arribada/argos-smd-hw/module-BGA_RG-4layers_v1.0.step

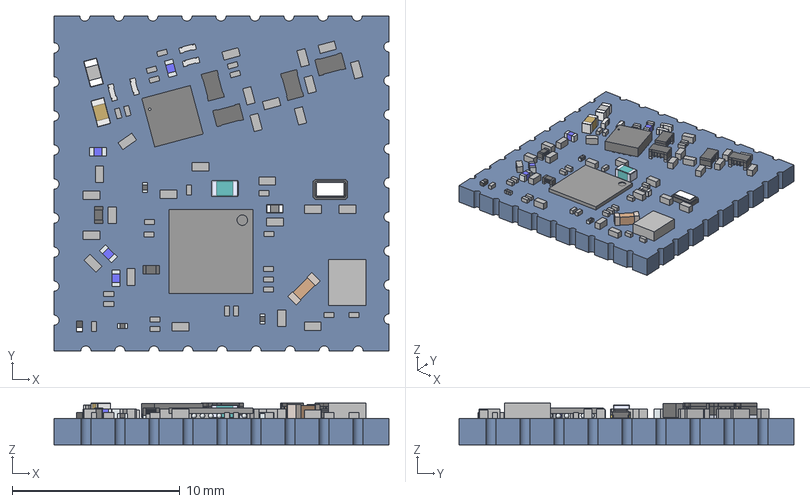
[picture p3: CAD file, 2025-10-09]
module-BGA_RG-4layers_v1.0.step
20.0 x 20.0 x 2.49 mm
Extruded x 55
term1 x 7
term2 x 7
Rect1 x 2
Rect2 x 2
Rect3 x 2
Rect4 x 2
Rect5 x 2
Rect6 x 2
Rect7 x 2
Rect8 x 2
Rect9 x 2
Rect10 x 2
Rect11 x 2
Chip Inductor 0603
A1
A2
A4
A5
A7
A8
A9
B1
B2
B3
B4
B5
B6
B7
B8
B9
C1
C2
C3
C4
C5
C6
C7
C8
D2
D3
D4
D5
D6
D7
D8
D9
E1
E2
E3
E4
E5
E6
E7
E8
E9
F1
F2
F3
F4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
