arribada/argos-smd-hw/(list of files, cad)

Other CAD files:
Project Outputs for BGA_RF-ArticGR/module-BGA_RG-4layers_v0.1d.step
