arribada/argos-smd-hw/Project Outputs for BGA_RF-ArticGR/stm32wl-dev_SMD_V0.1d_20230822/stm32wl-dev_SMD_V0.1d_Schematics_PCB.pdf

1 5

Title: Schematic sheet title to update

Size:

Reference:
A4 | Sheet: | of

Revision:

Project: Horizon(x) module SMD Argos with RG5804 PA

BGA_RF-RGPA

[No Variations]

Date:

Variant:

Table of contents | Legend

General comment such as function title, configuration, ...

Sheet 2: module-BGA-RG | Text to be added to silkscreen.

Sheet 1: Project overview (this page)

# Horizon(x) module SMD Argos with RG5804 PA

# BGA_RF-RGPA

Sheet 3: stm32wl55jci7-details

Device Sheets: | Warning text.

# OPEN PLATFORM LICENSE AGREEMENT

The Open Platform License Agreement (“Agreement”) is a binding legal contract between you ("You")

and STMicroelectronics International N.V. (“ST”), a company incorporated under the laws of the

Netherlands acting for the purpose of this Agreement through its Swiss branch 39, Chemin du

Champ des Filles, 1228 Plan-les-Ouates, Geneva, Switzerland.

By using the enclosed reference designs, schematics, PC board layouts, and documentation, in hardcopy

or CAD tool file format (collectively, the “Reference Material”), You are agreeing to be bound by

the terms and conditions of this Agreement. Do not use the Reference Material until You have read

and agreed to this Agreement terms and conditions. The use of the Reference Material automatically

implies the acceptance of the Agreement terms and conditions.

The complete Open Platform License Agreement can be found on www.st.com/opla.

Sheet 5: CLS_1W_3.3V_Lineup

Sheet 4: STM32RF_power_SMPS

U_module-BGA-RG
module-BGA-RG.SchDoc

Notes to generate the
board layout.

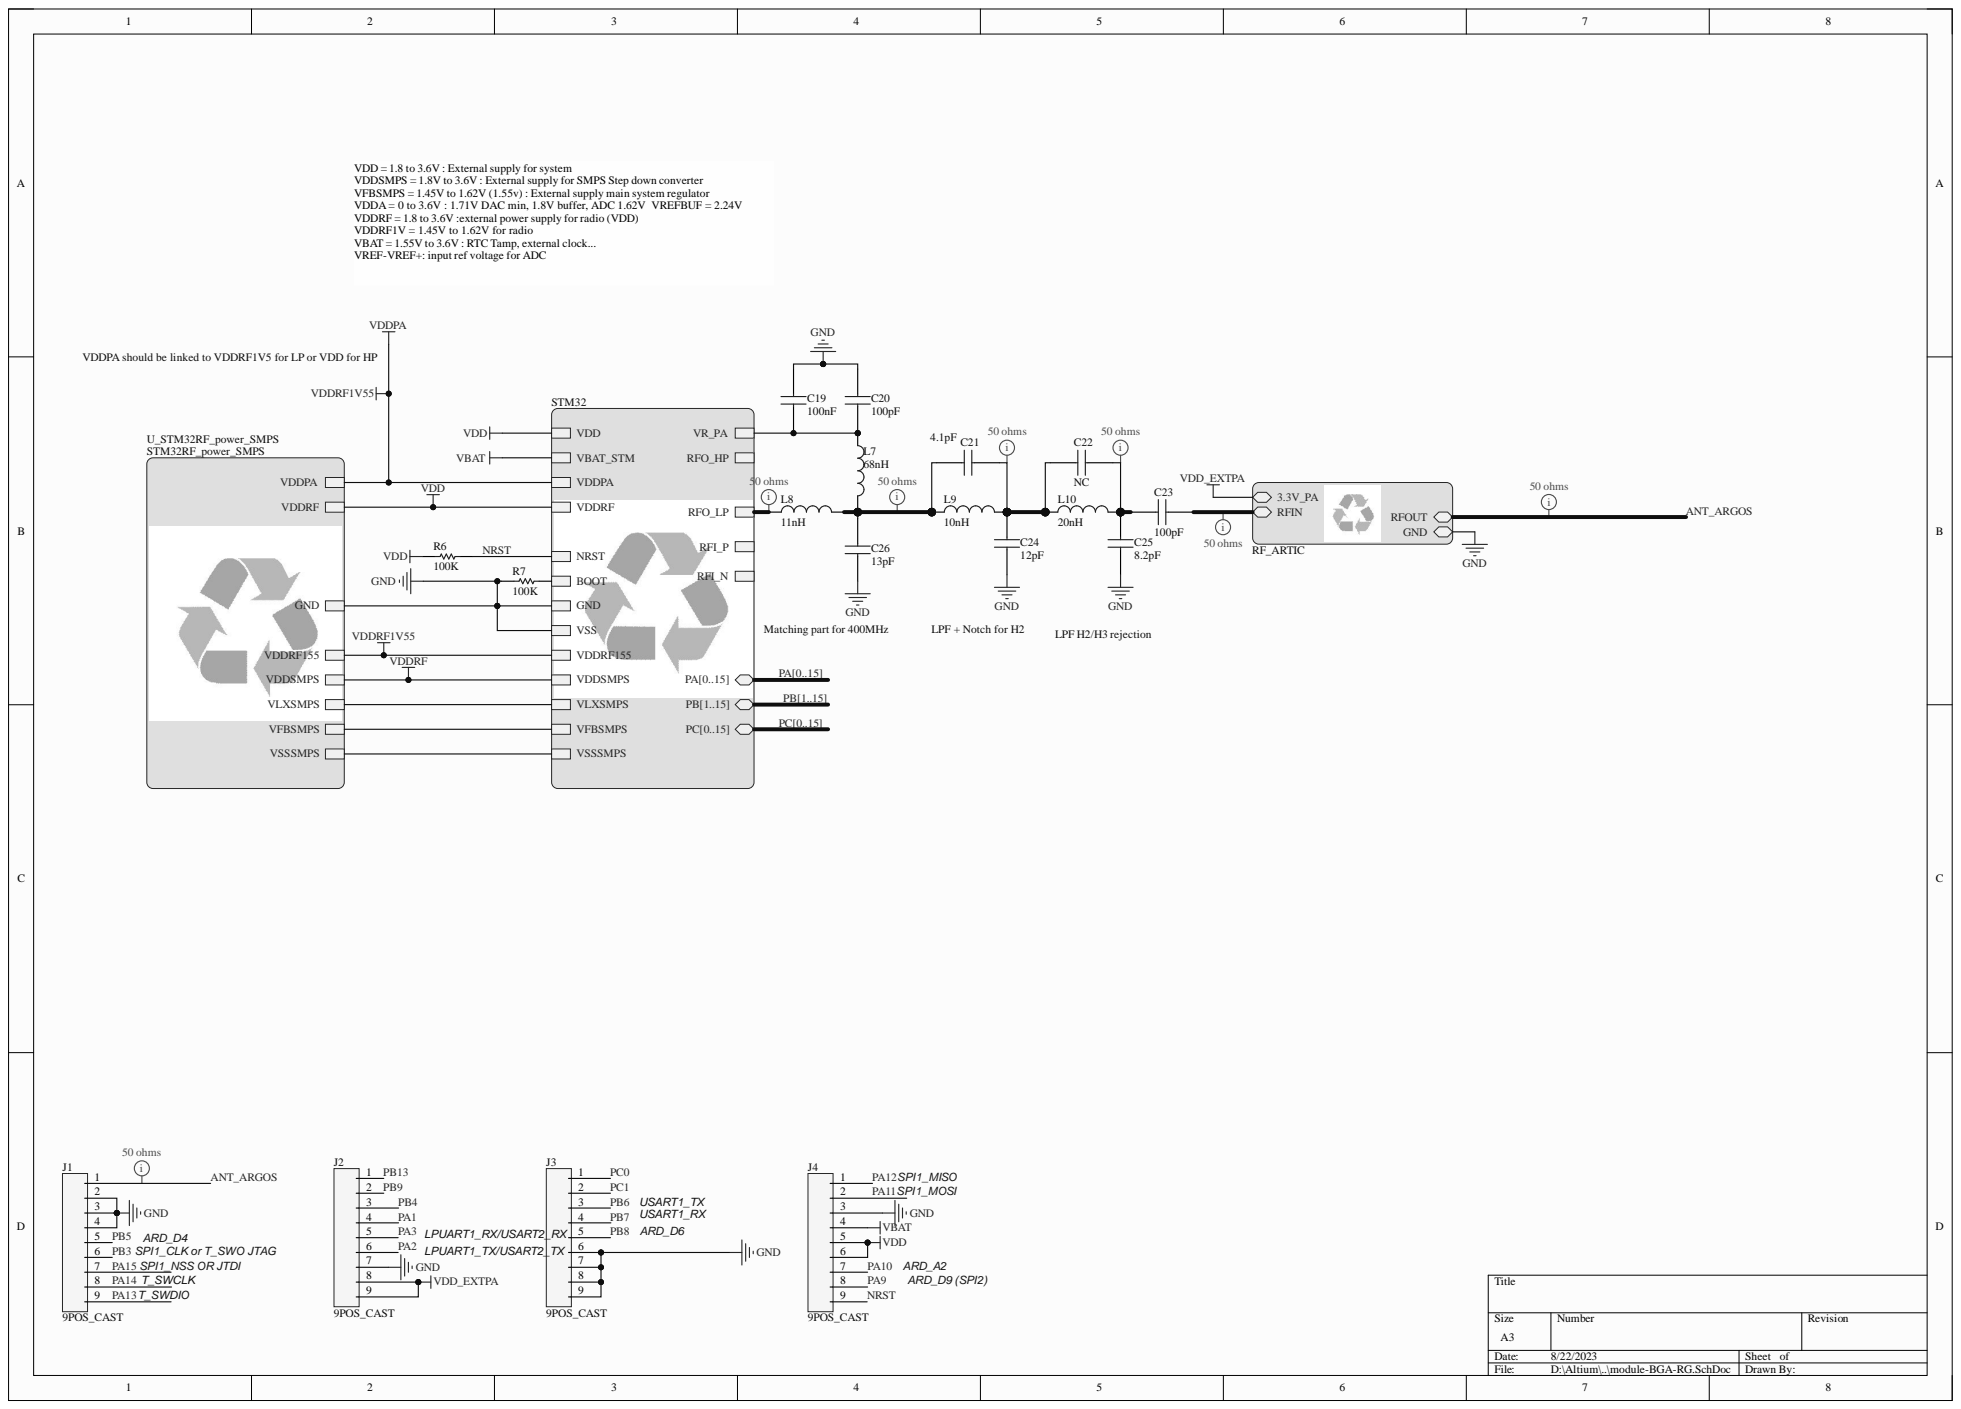
[picture p5: page 2]

VDD = 1.8 to 3.6V : External supply for system
VDDSMPS = 1.8V to 3.6V : External supply for SMPS Step down converter
VFBSMPS = 1.45V to 1.62V (1.55v) : External supply main system regulator
VDDA = 0 to 3.6V : 1.71V DAC min, 1.8V buffer, ADC 1.62V VREFBUF = 2.24V
VDDRF = 1.8 to 3.6V :external power supply for radio (VDD)
VDDRF1V = 1.45V to 1.62V for radio
VBAT = 1.55V to 3.6V : RTC Tamp, external clock...
VREF-VREF+: input ref voltage for ADC

VDDPA should be linked to VDDRF1V5 for LP or VDD for HP

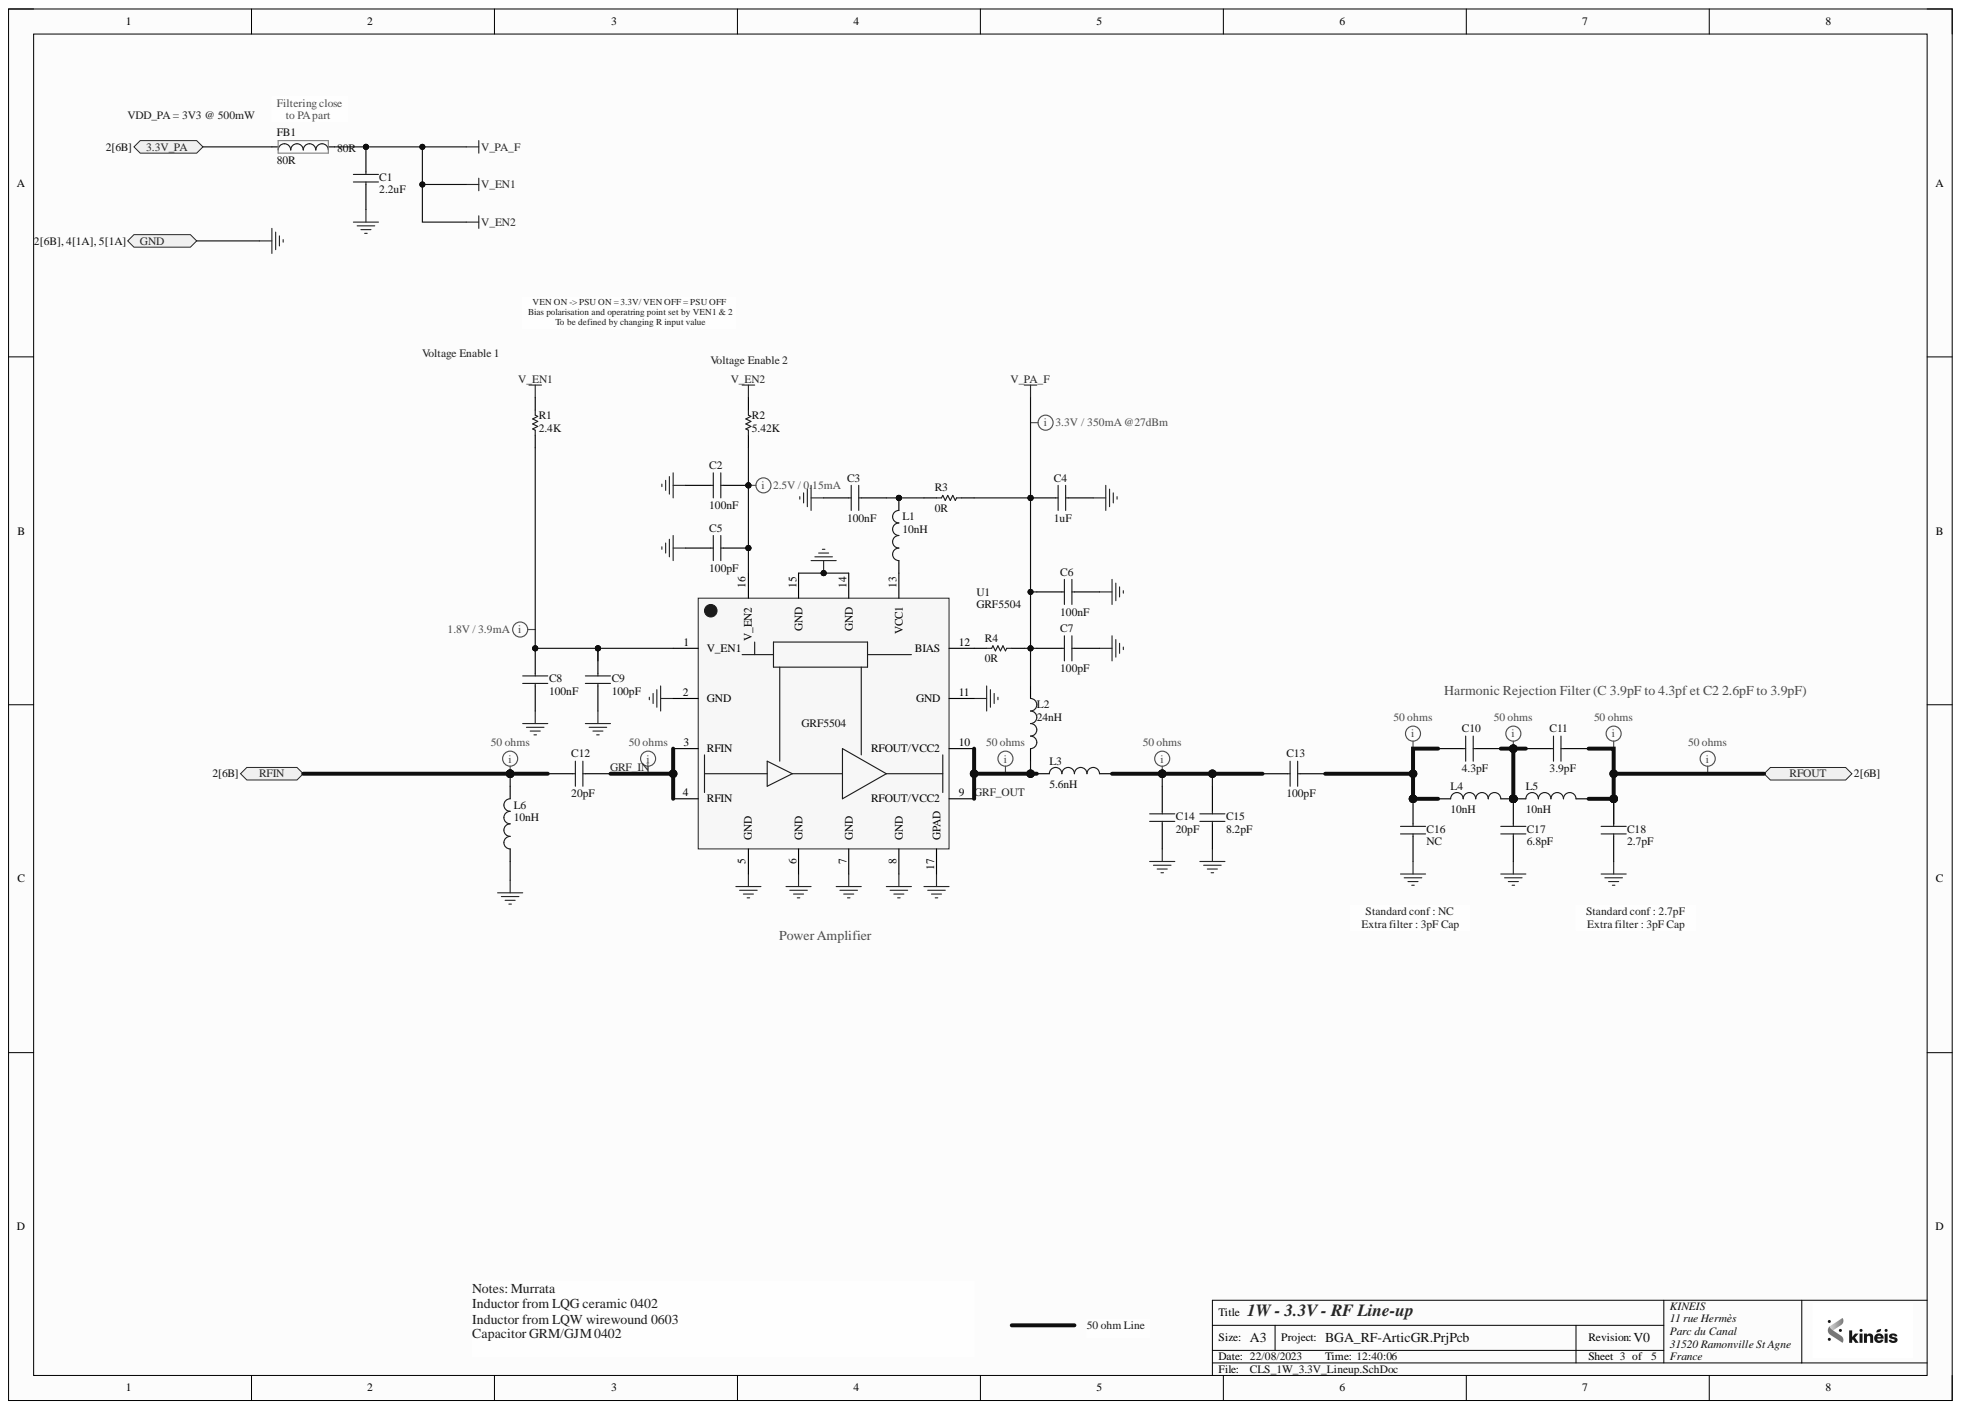
[picture p6: page 3]

VEN ON -> PSU ON = 3.3V/ VEN OFF = PSU OFF
Bias polarisation and operatring point set by VEN1 & 2

To be defined by changing R input value

Harmonic Rejection Filter (C 3.9pF to 4.3pf et C2 2.6pF to 3.9pF)

Notes: Murrata
Inductor from LQG ceramic 0402
Inductor from LQW wirewound 0603
Capacitor GRM/GJM 0402

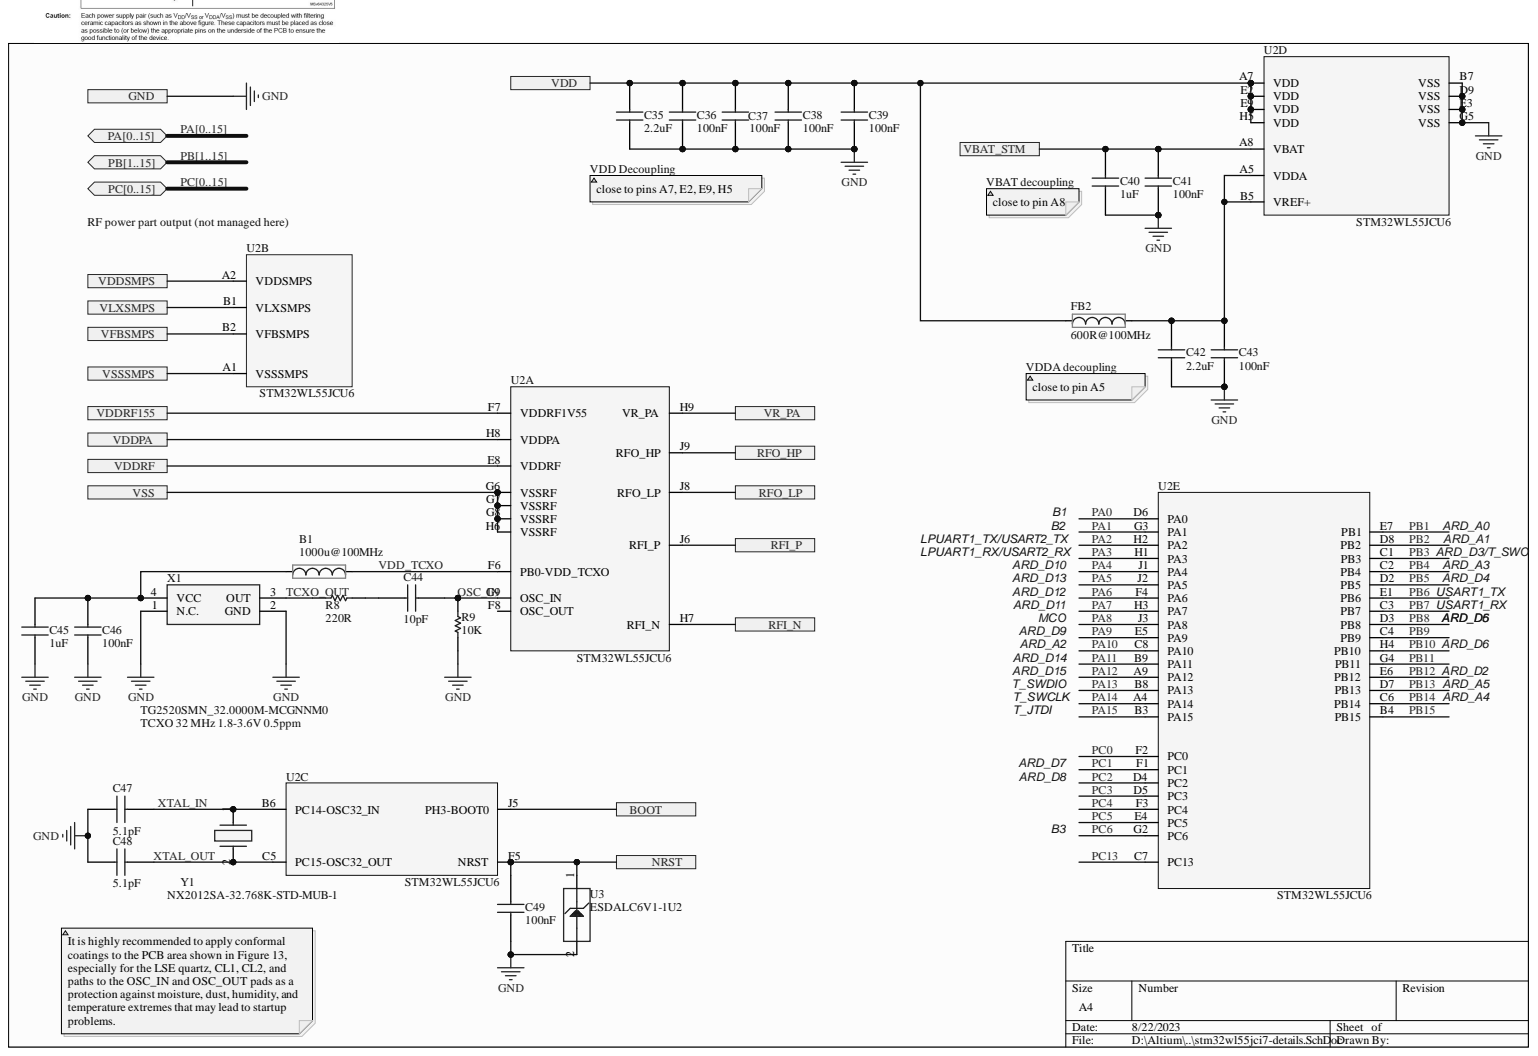
[picture p7: page 4]

RF power part output (not managed here)

It is highly recommended to apply conformal
coatings to the PCB area shown in Figure 13,
especially for the LSE quartz, CL1, CL2, and
paths to the OSC_IN and OSC_OUT pads as a
protection against moisture, dust, humidity, and
temperature extremesthat may lead to startup
problems.

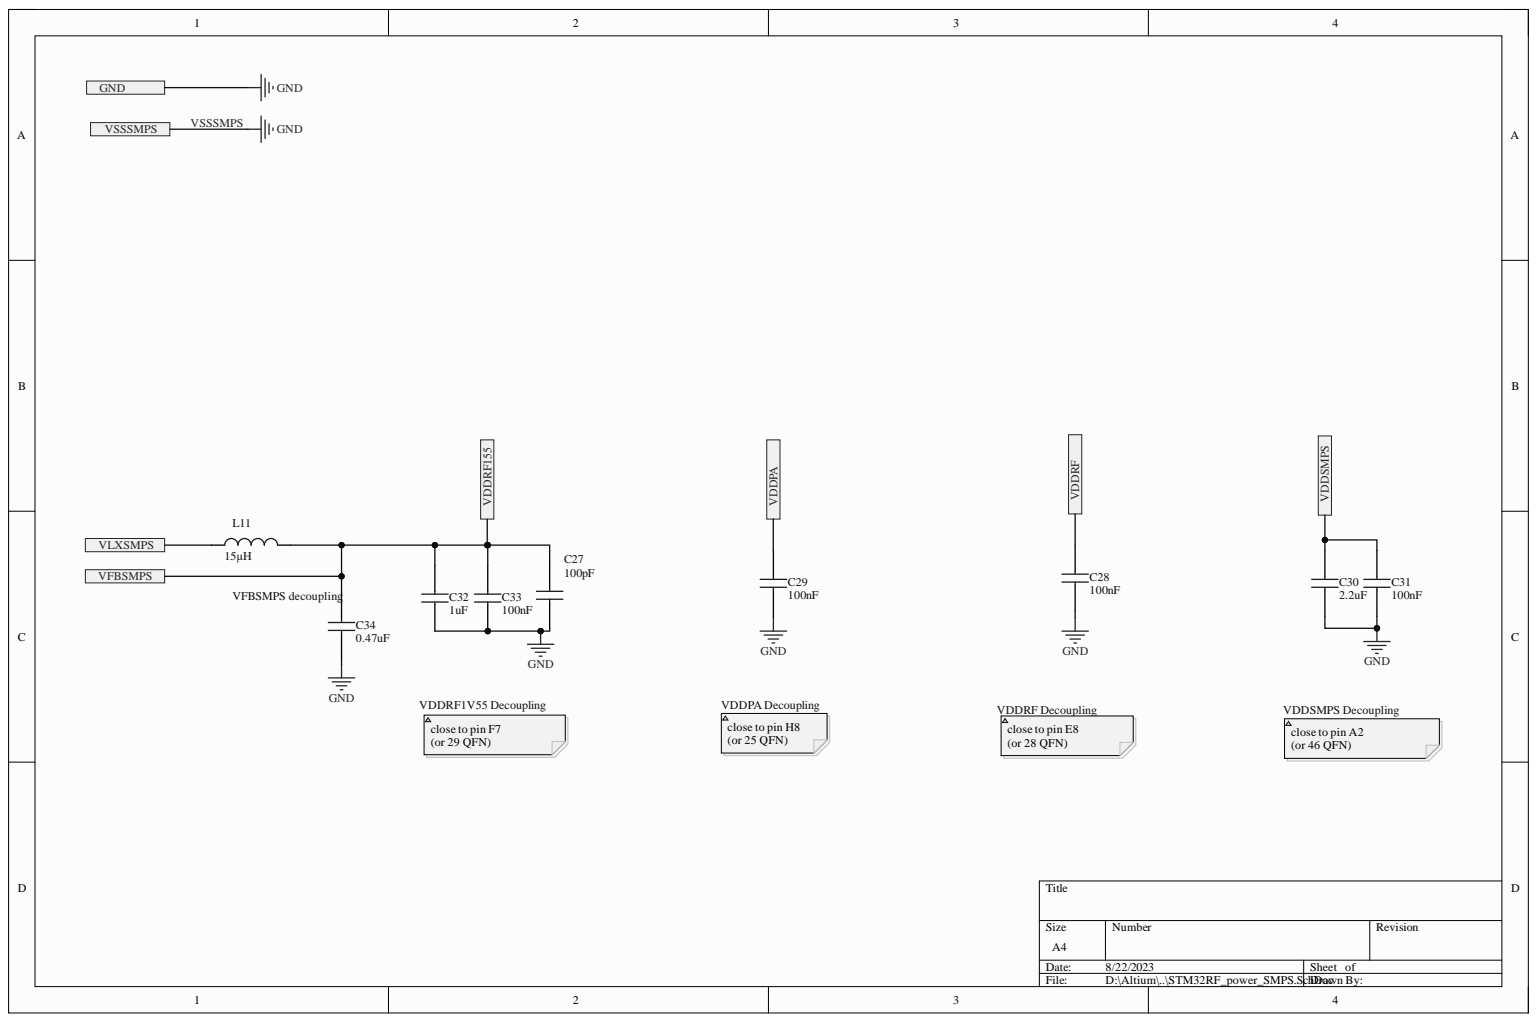
[picture p8: page 5]

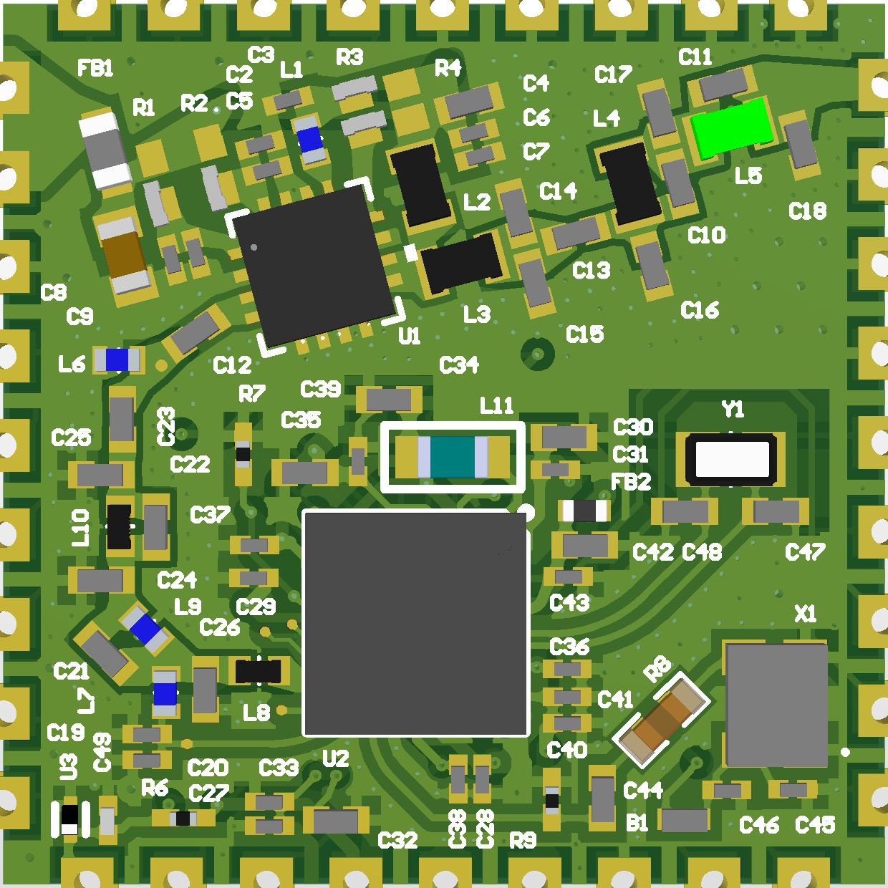
[picture p9: page 7]

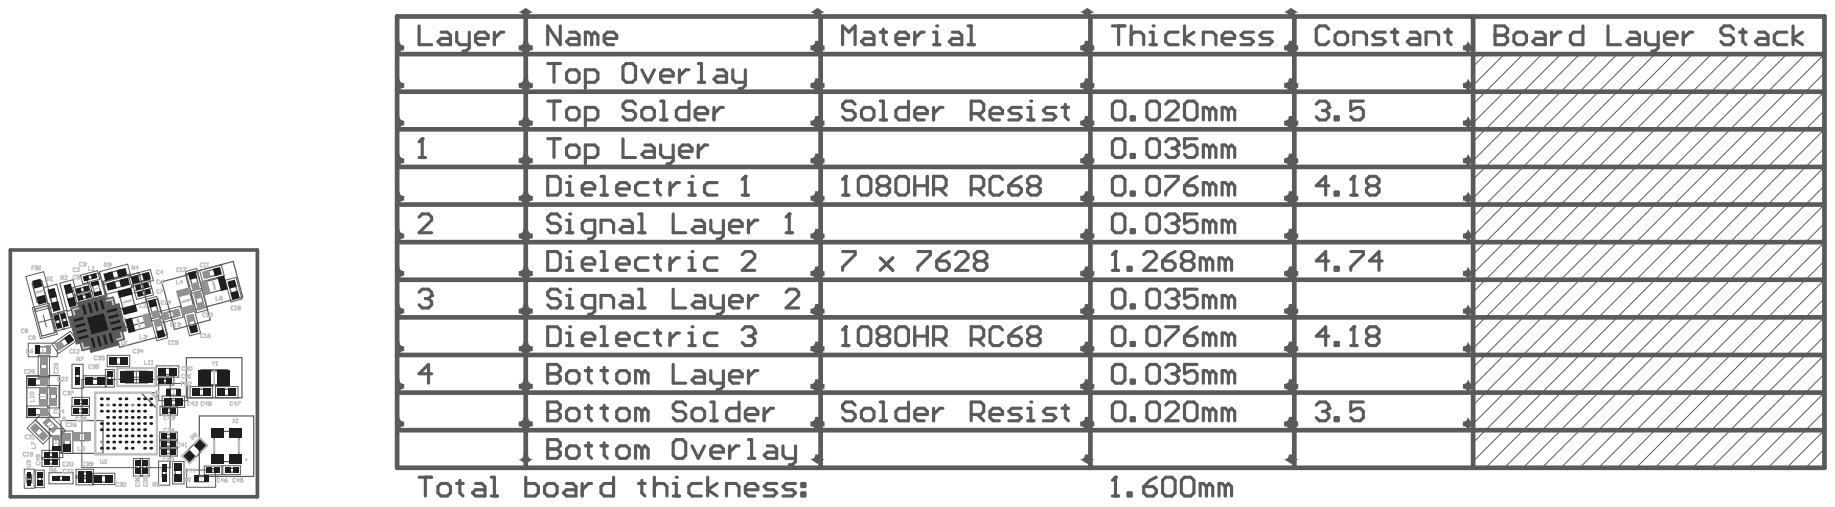
[picture p10: page 8]

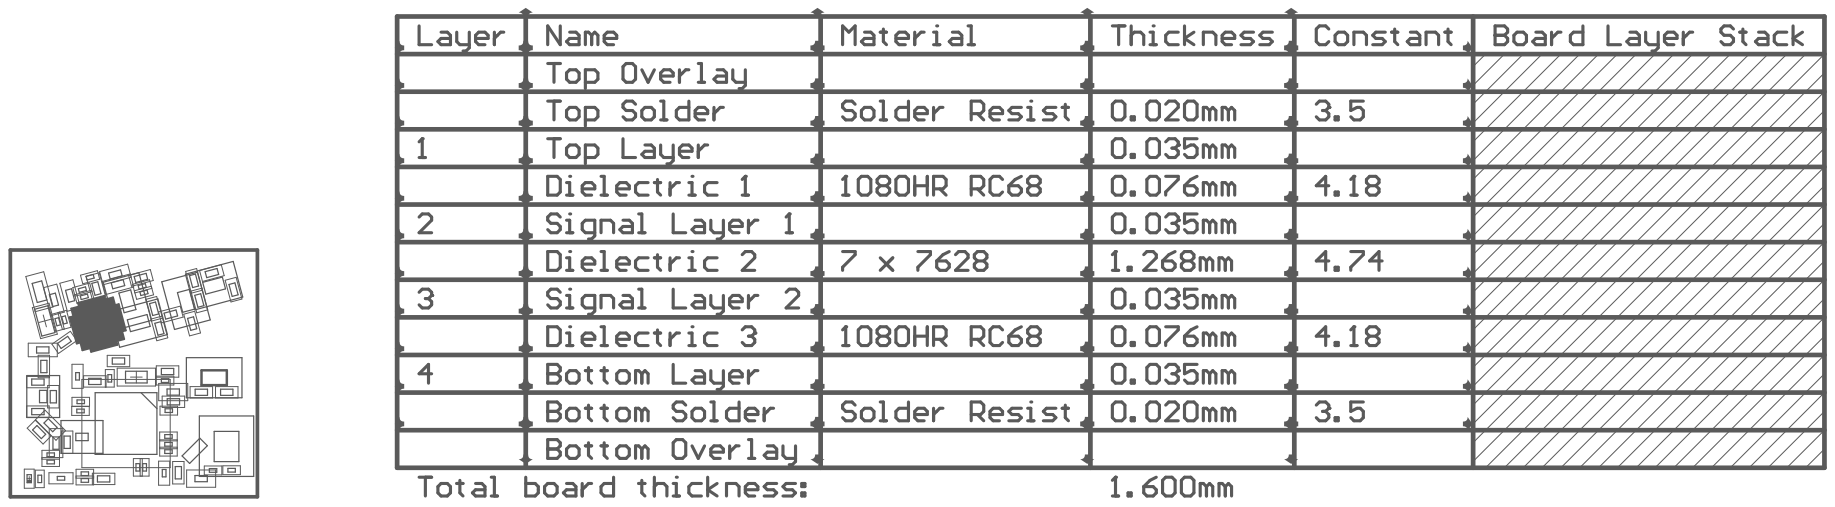
[picture p11: page 9]
