arribada/argos-smd-hw/stm32wl-dev_SMD_V1.0_202404.pdf

D | D
C | C
B | B
A | A

## Arribada Initiative https://github.com/arribada contact@arribada.org arribada.org

5 | UK - Portsmouth

# HorizonLink-SMD

# argos-smd

22/11/2024 | 16:45:39

## D:\Altium\Projects\stm32wl-dev\Projects\argos-smd-hw\Project_Overview.SchDoc

## Title

Size: | Reference:

## Date: File:

## Revision:

Time: | Sheet | of
A4 | 1.0
Table of contents | Legend

General comment such as function title, configuration, ...

Sheet 2: module-BGA-RG | Text to be added to silkscreen.

## Sheet 1: Project overview (this page)

# HorizonLink-SMD

# argos-smd

## Sheet 3: stm32wl55jci7-details

Device Sheets: | Warning text.

# OPEN HARDWARE LICENSE AGREEMENT

## Sheet 5: CLS_1W_3.3V_Lineup

## Sheet 4: STM32RF_power_SMPS

## argos-smd-module

The Open Hardware License Agreement (“Agreement”) is a binding legal contract between you ("You") and the creators of this design, as represented by the Arribada Initiative, under the terms of the GNU General Public License version 3 (“GPLv3”). This license governs the use, modification, and distribution of the open-design PCB and any associated design files or materials (collectively referred to as the “Reference Material”).

By accessing, using, or modifying the Reference Material, You agree to be bound by the terms and conditions of the GPLv3. If you do not agree to these terms, do not use the Reference Material. Your use of the Reference Material constitutes acceptance of this Agreement.

The complete GNU General Public License version 3 can be found at www.gnu.org/licenses/gpl-3.0.html.

For more details about this open-design PCB project and its licensing, please visit the Arribada Initiative website or contact us directly.

## Notes to generate the

board layout.

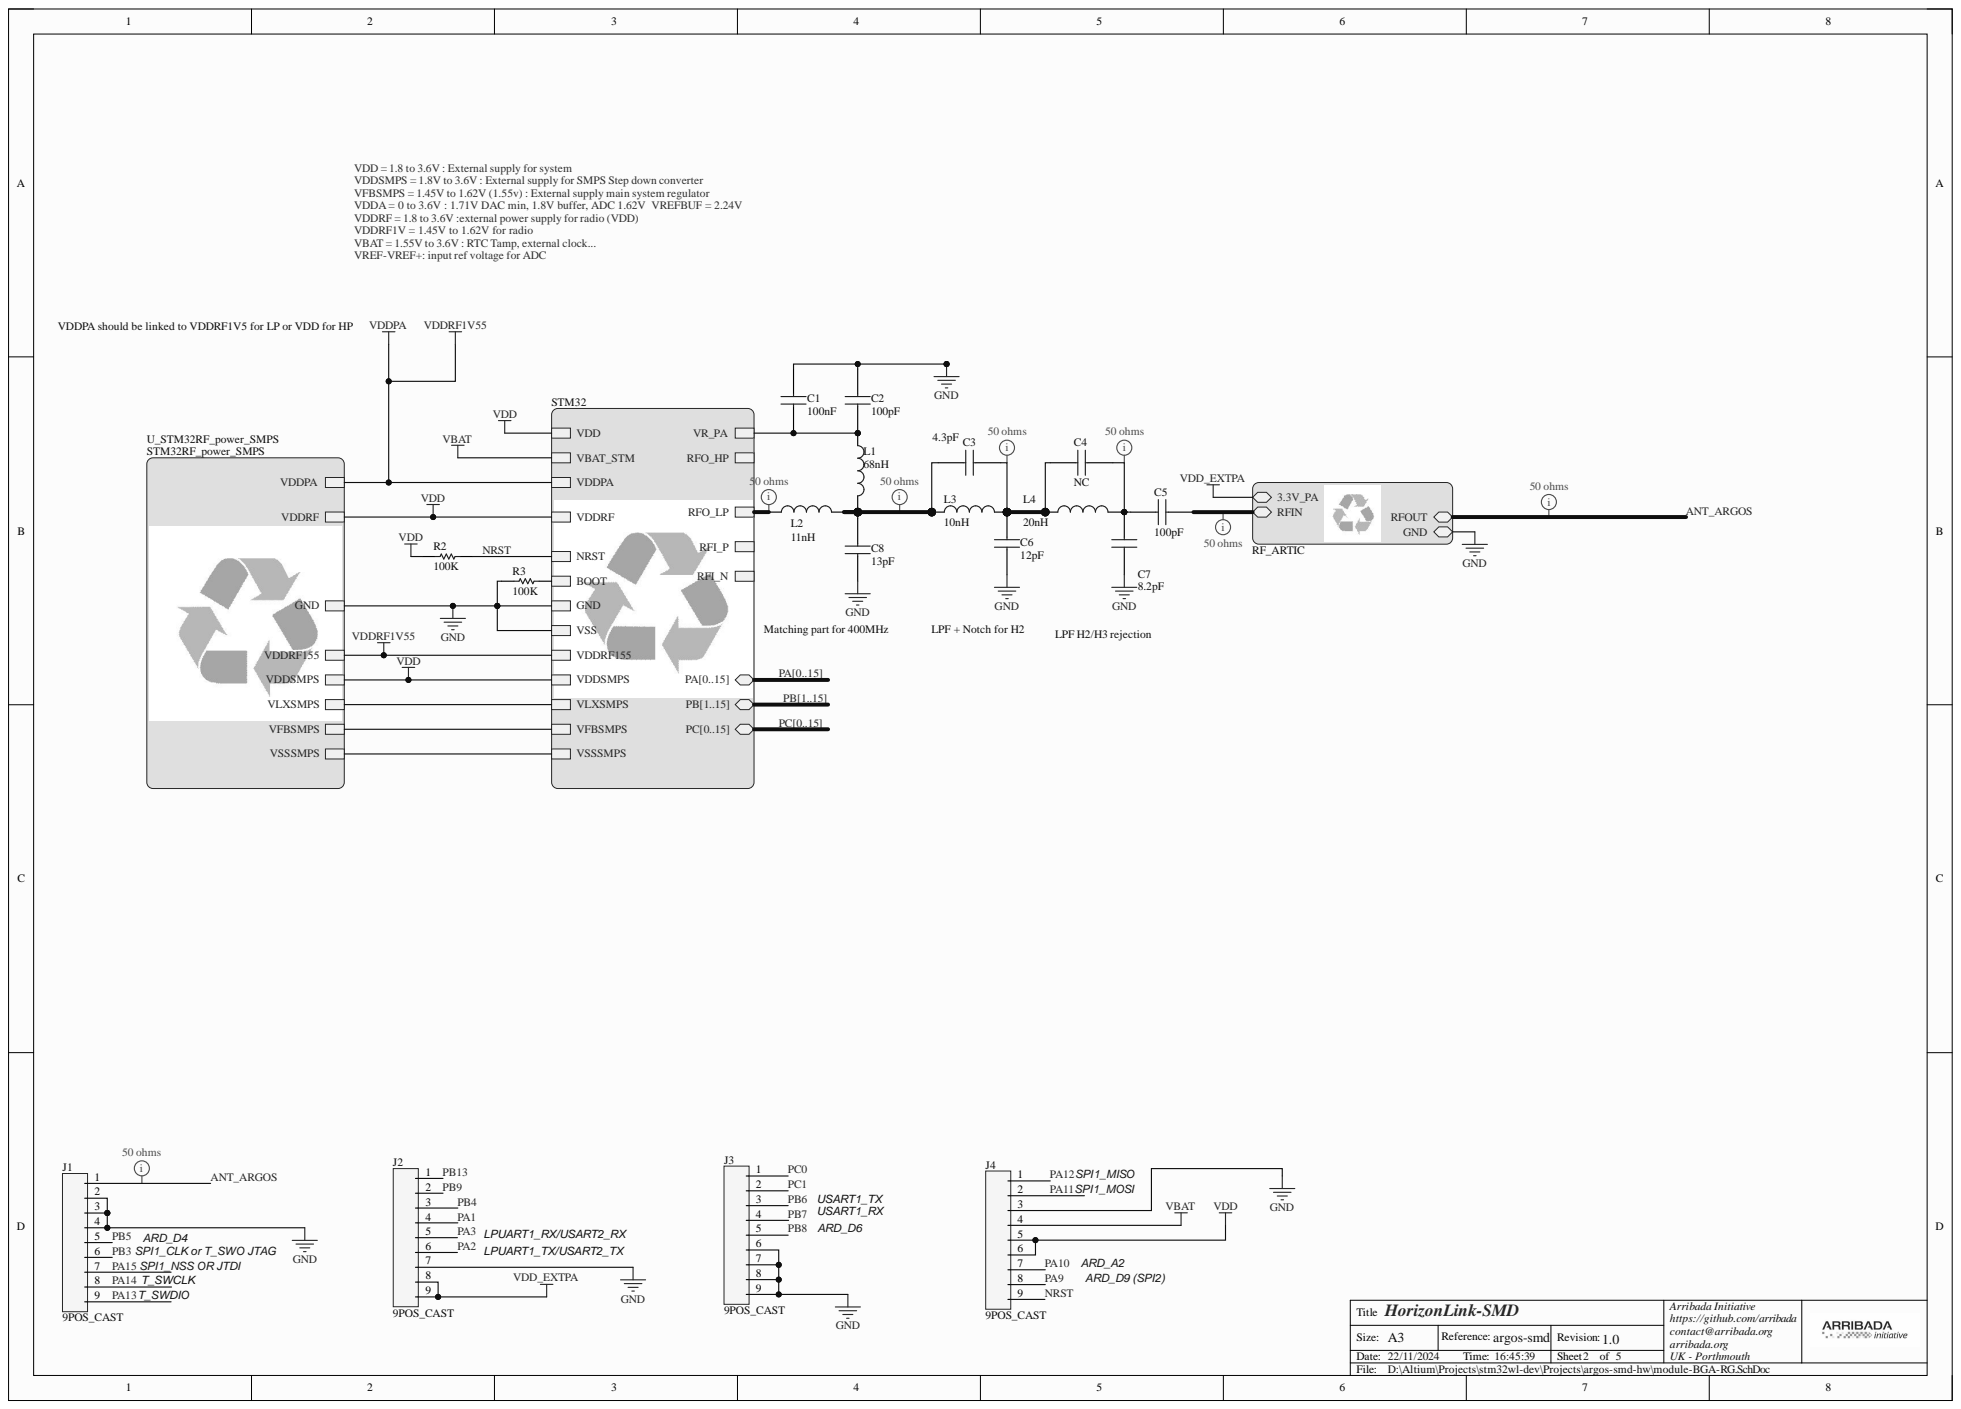
[picture p12: page 2]

VDD = 1.8 to 3.6V : External supply for system
VDDSMPS = 1.8V to 3.6V : External supply for SMPS Step down converter
VFBSMPS = 1.45V to 1.62V (1.55v) : External supply main system regulator
VDDA = 0 to 3.6V : 1.71V DAC min, 1.8V buffer, ADC 1.62V VREFBUF = 2.24V
VDDRF = 1.8 to 3.6V :external power supply for radio (VDD)
VDDRF1V = 1.45V to 1.62V for radio
VBAT = 1.55V to 3.6V : RTC Tamp, external clock...
VREF-VREF+: input ref voltage for ADC

VDDPA should be linked to VDDRF1V5 for LP or VDD for HP

Arribada Initiative
https://github.com/arribada
contact@arribada.org
arribada.org

D:\Altium\Projects\stm32wl-dev\Projects\argos-smd-hw\module-BGA-RG.SchDoc

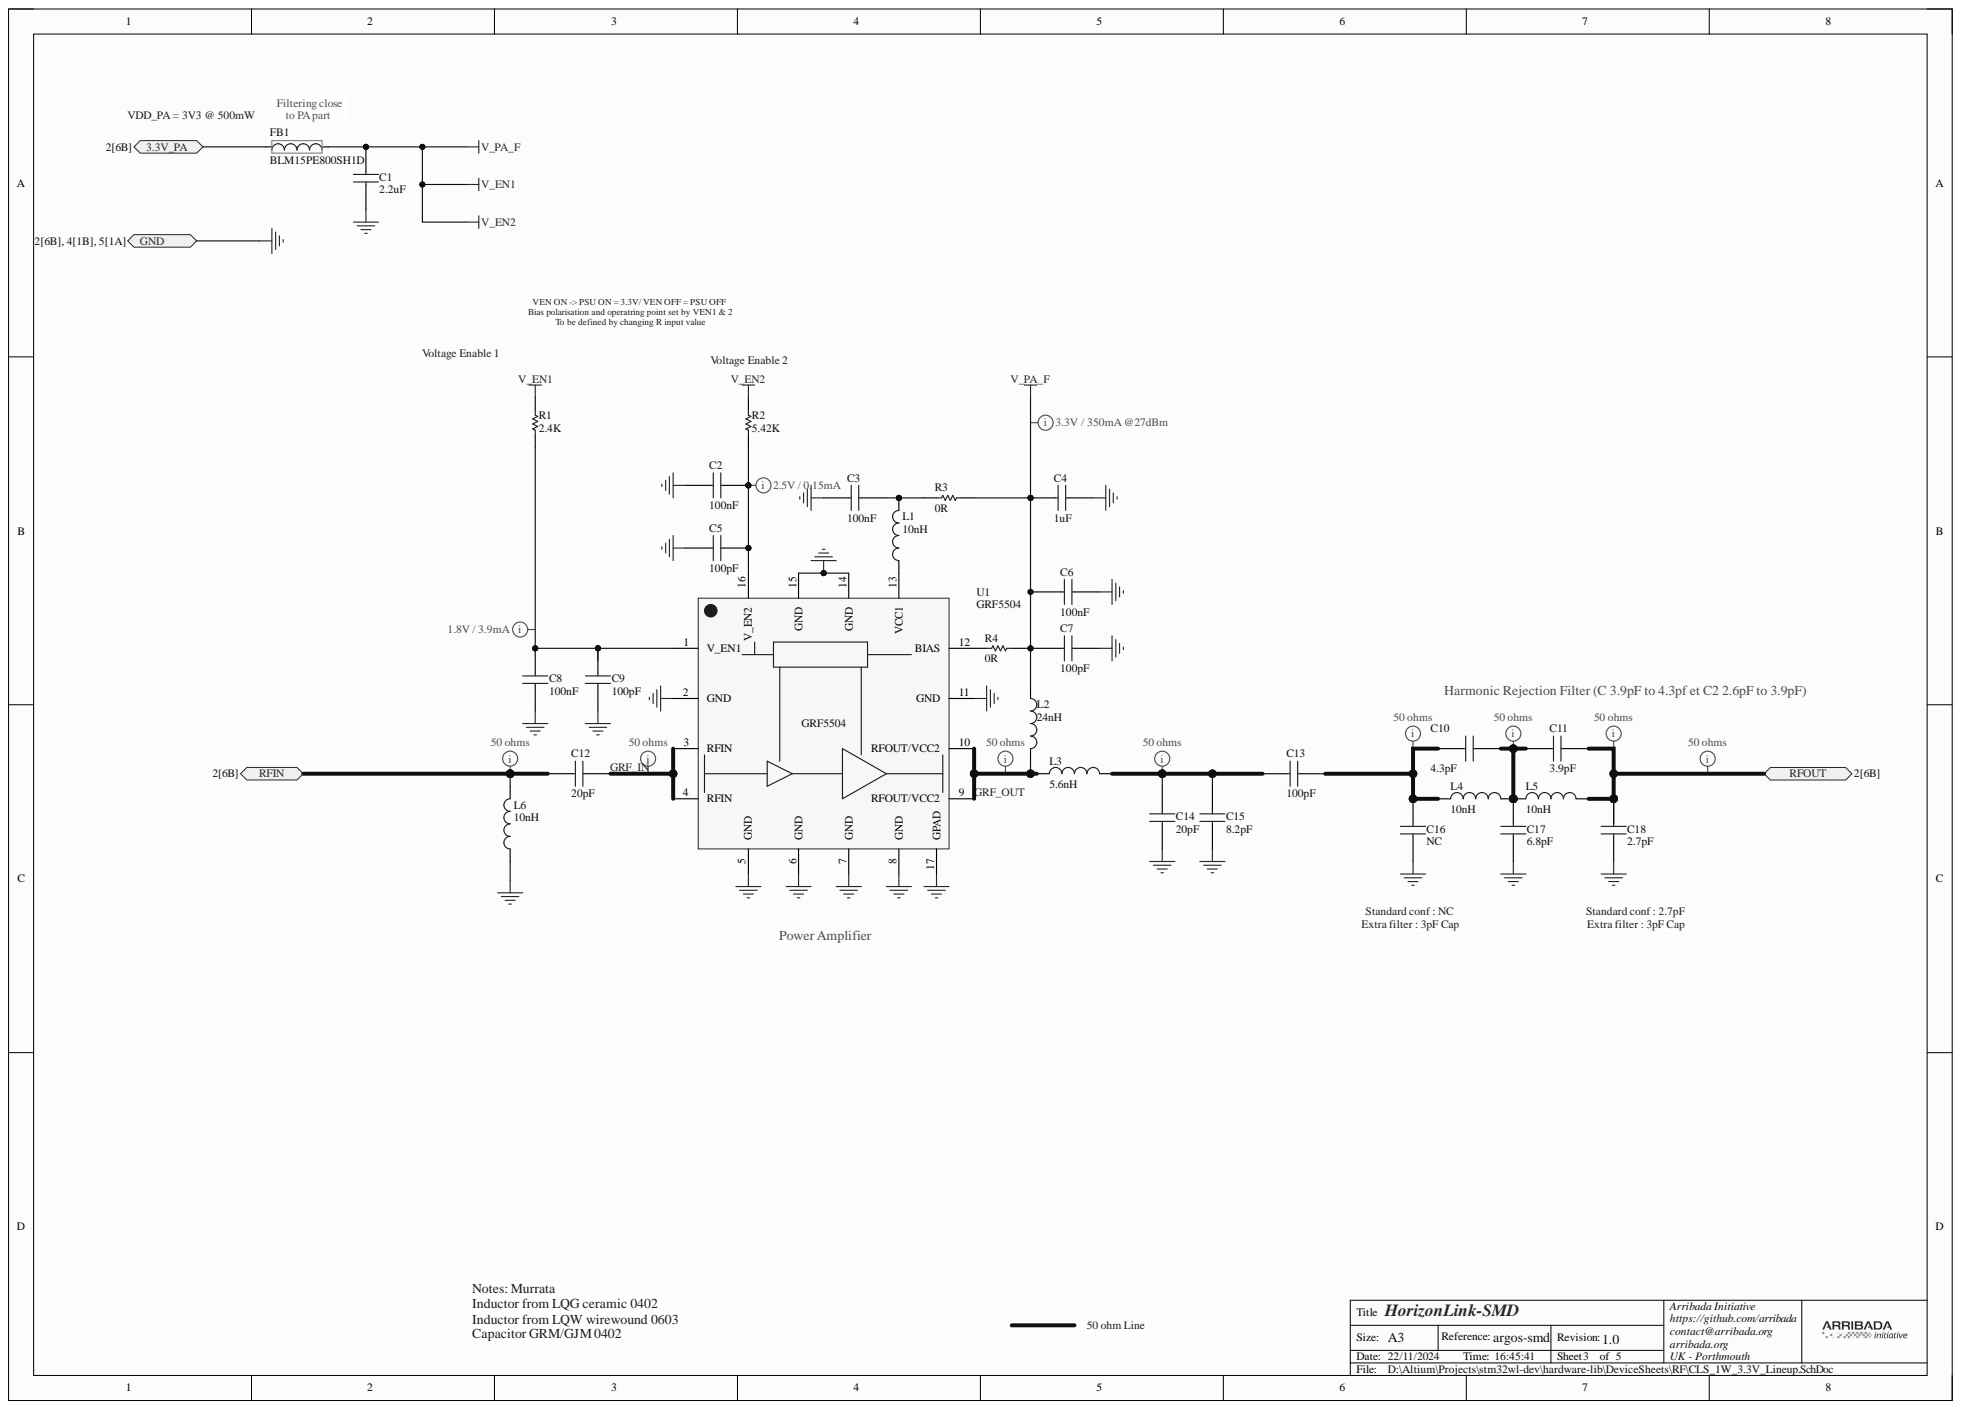
[picture p13: page 3]

VEN ON -> PSU ON = 3.3V/ VEN OFF = PSU OFF
Bias polarisation and operatring point set by VEN1 & 2

To be defined by changing R input value

Harmonic Rejection Filter (C 3.9pF to 4.3pf et C2 2.6pF to 3.9pF)

Notes: Murrata
Inductor from LQG ceramic 0402
Inductor from LQW wirewound 0603
Capacitor GRM/GJM 0402

Arribada Initiative
https://github.com/arribada
contact@arribada.org
arribada.org

D:\Altium\Projects\stm32wl-dev\hardware-lib\DeviceSheets\RF\CLS_1W_3.3V_Lineup.SchDoc

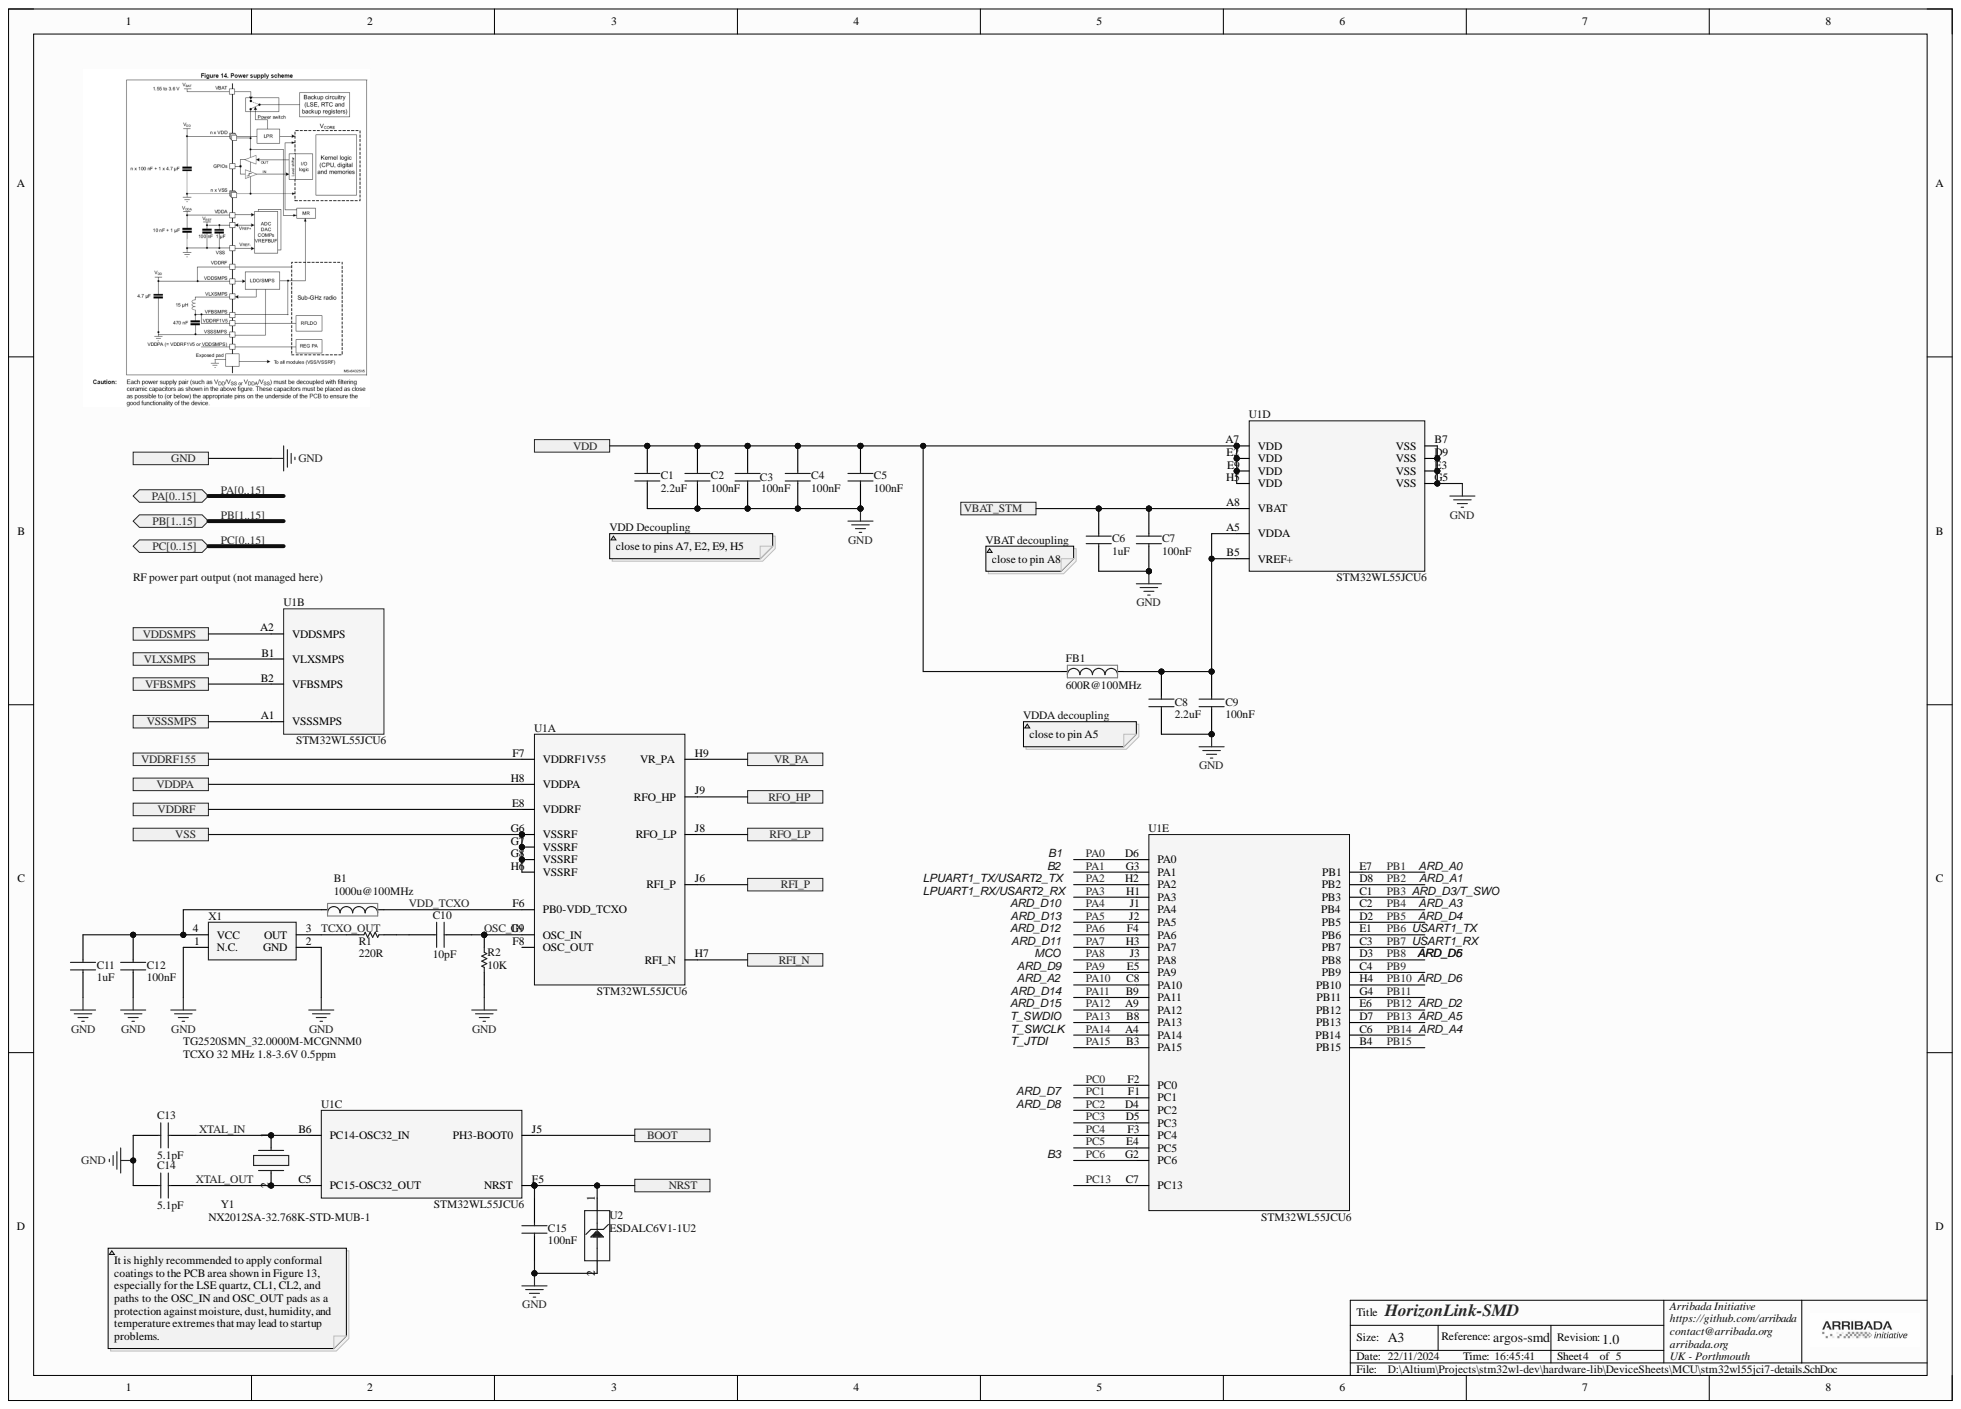
[picture p14: page 4]

RF power part output (not managed here)

VLXSMPS | VFBSMPS B2

VDDRF155 | VDDPA H8 | VR_PA

It is highly recommended to apply conformal
coatings to the PCB area shown in Figure 13,
especially for the LSE quartz, CL1, CL2, and
paths to the OSC_IN and OSC_OUT pads as a
protection against moisture, dust, humidity, and
temperature extremesthat may lead to startup
problems.

Arribada Initiative
https://github.com/arribada
contact@arribada.org
arribada.org

D:\Altium\Projects\stm32wl-dev\hardware-lib\DeviceSheets\MCU\stm32wl55jci7-details.SchDoc

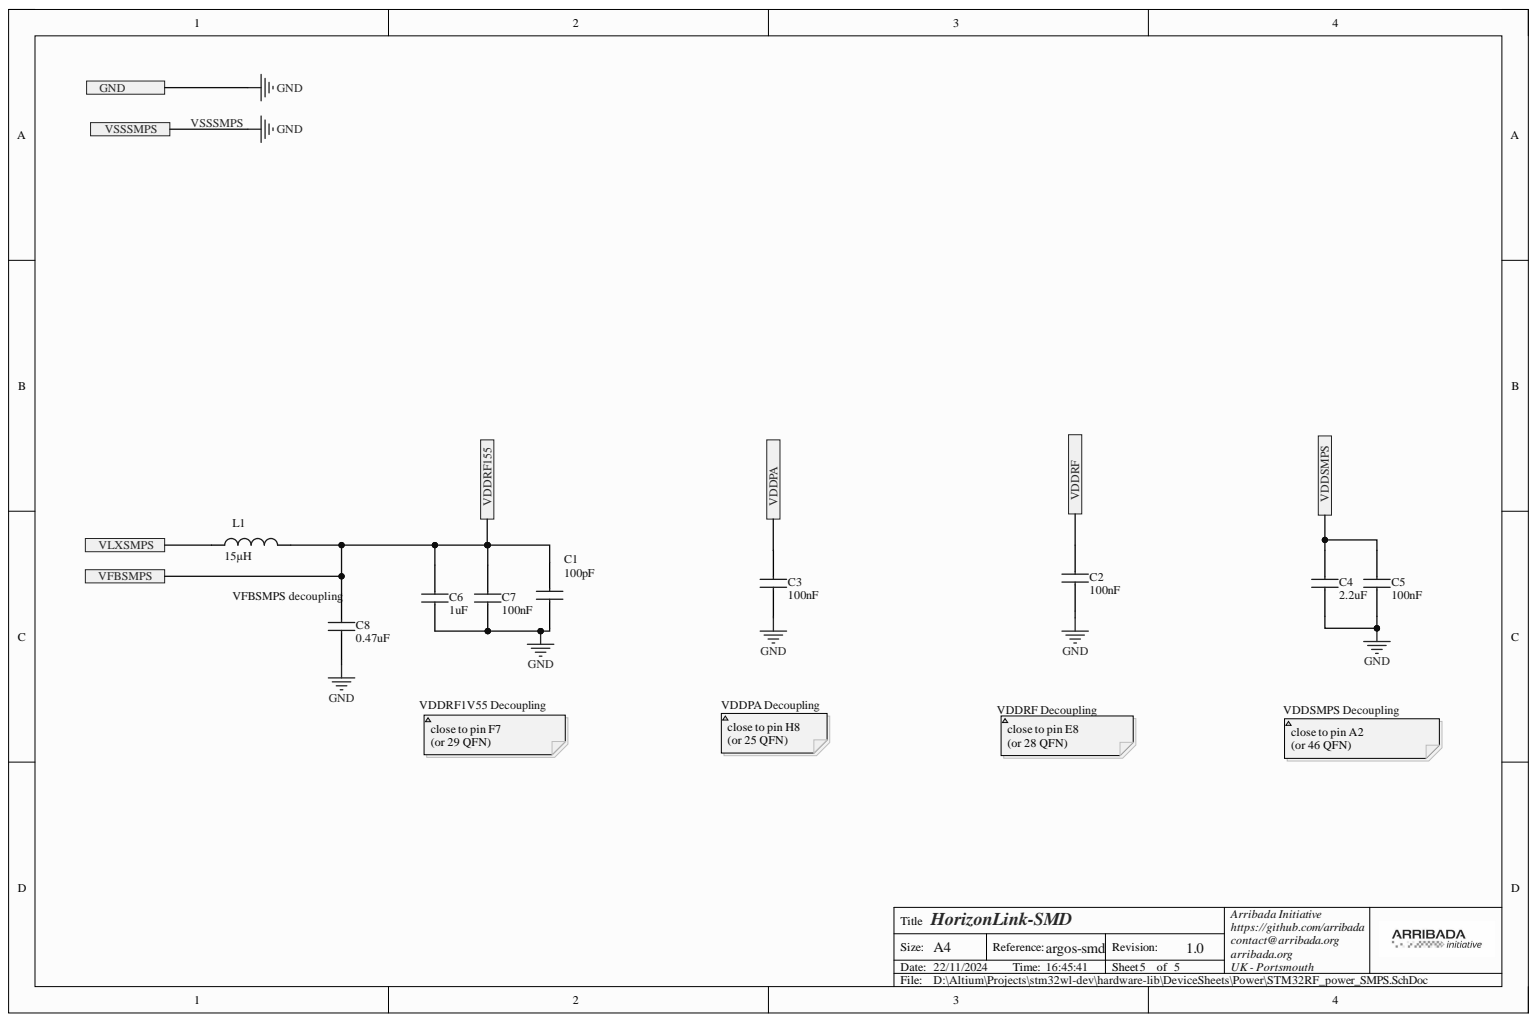
[picture p15: page 5]

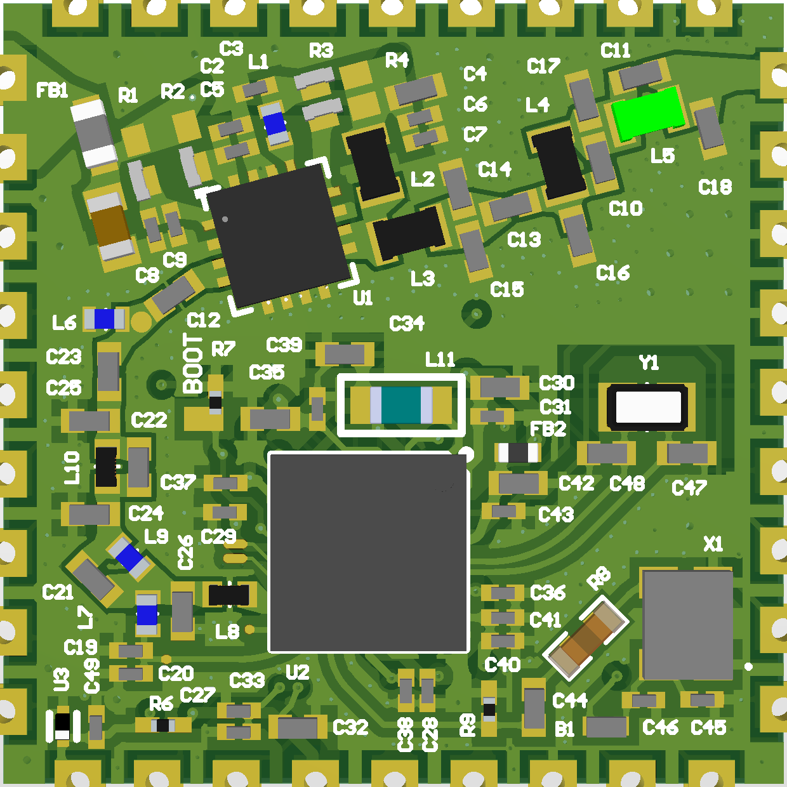
[picture p16: page 7]

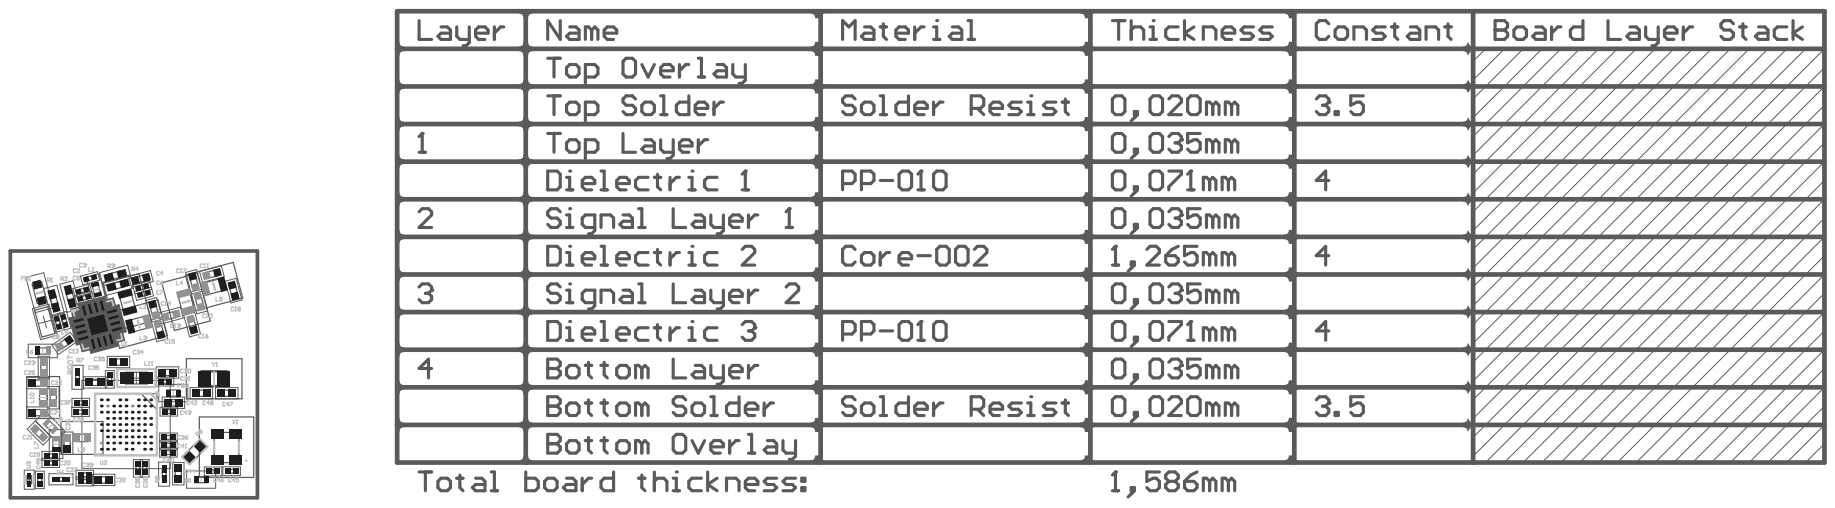
[picture p17: page 8]

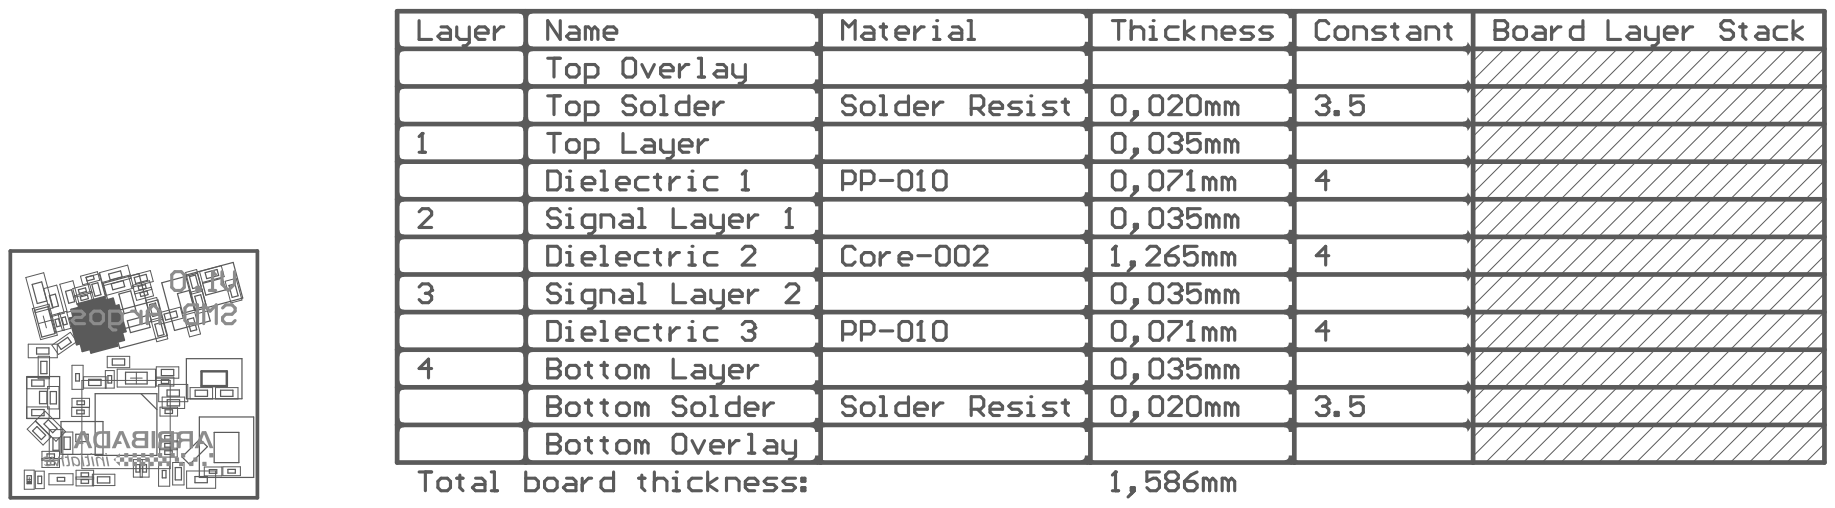
[picture p18: page 9]

Line# | Name | Description | Designator | Quantity | Manufacturer 1 | Manufacturer Part Number 1 | Manufacturer Lifecycle 1 | Supplier 1 | Supplier Part Number 1 | Supplier Unit Price 1 | Supplier Subtotal 1
| 1000u@1 00MHz | FerriteBead- BLM15_Z1DSeriesEMISuppressionFilter 1000+/-25%at 100MHz250mA@85 | B1 | 1 Murata | | BLM15HG102SZ1D | VolumeProduction
| 2.2uF | Multilayer Ceramic CapacitorsMLCC- SMD/SMT2.2 uF10VDC10%0603X7R | C1 | 1 Murata | | GRM188R71A225KE15D | VolumeProduction | Mouser | 81-GRM188R71A225KE15
| 100nF | Multilayer Ceramic CapacitorsMLCC- SMD/SMT.1UF 16V 10% 0201 | C2, C3, C6, C8, C19, C31, C33, C36, C37, C38, C39, C41, C43, C46, C49 | 15 Murata | | GRM033Z71C104KE14D | VolumeProduction | Mouser | 81-GRM033Z71C104KE4D
| 1uF | Multilayer Ceramic CapacitorsMLCC- SMD/SMT1.0UF10V10%0402 | C4, C32 | 2 Murata | | GRM155Z71A105KE01J | VolumeProduction | Mouser | 81-GRM155Z71A105KE1J
| 100pF | Multilayer Ceramic CapacitorsMLCC- SMD/SMT100PF25V5%0201 | C5, C7, C9, C20 | 4 Murata | | GRM0335C1E101JA01D | VolumeProduction | Mouser | 81-GRM0335C1E101JA1D
| GRM1555 C1H4R3B A01D | Multilayer Ceramic CapacitorsMLCC- SMD/SMT4.3 pF50VDC0.1 pF0402C0G(NP0) | C10, C21 | 2 Murata | | GRM1555C1H4R3BA01D | | Digi-Key | 490-6243-1-ND
| GRM1555 C1E3R9B A01D | Multilayer Ceramic CapacitorsMLCC- SMD/SMT3.9 pF25VDC0.1 pF0402C0G(NP0) | C11 | 1 Murata | | GRM1555C1E3R9BA01D | | Mouser | 81-GRM1555C1E3R9BA1D
| 20pF | Multilayer Ceramic CapacitorsMLCC- SMD/SMT20pF50VDC2%0402C0G(NP0) | C12, C14 | 2 Murata | | GRM1555C1H200GA01D | Not Recommendedfor NewDesign | Mouser | 81-GRM1555C1H200GA1D
| GCM1555 C1H101JA 16D | Multilayer Ceramic CapacitorsMLCC- SMD/SMT100pF50VDC5%0402C0G(NP0) AEC-Q200 C13, C23 | | 2 Murata | | GCM1555C1H101JA16D | | Mouser | 81-GCM1555C1H101JA6D
| GCM1555 C1H8R2C A16J | Multilayer Ceramic CapacitorsMLCC- SMD/SMT8.2 pF50VDC0.25pF0402C0G(NP0) AEC-Q200 | C15, C25 | 2 Murata | | GCM1555C1H8R2CA16J | VolumeProduction | Mouser | 81-GCM1555C1H8R2CA6J
| CAP-NC-0402 | CMS0402NonConnected | C16, C22 | 2
| GRM1555 C1E6R8B A01D | Multilayer Ceramic CapacitorsMLCC- SMD/SMT6.8 pF25VDC0.1 pF0402C0G(NP0) | C17 | 1 Murata | | GRM1555C1E6R8BA01D | | Mouser | 81-GRM1555C1E6R8BA1D
| GRM1555 C2A2R7C A01D | Multilayer Ceramic CapacitorsMLCC- SMD/SMT2.7 pF100VDC0.25pF0402C0G(NP0) | C18 | 1 Murata | | GRM1555C2A2R7CA01D | | Mouser | 81-GRM1555C2A2R7CA1D
| GCM1555 C1H120G A16D | Multilayer Ceramic CapacitorsMLCC- SMD/SMT12pF50VDC2%0402C0G(NP0) AEC-Q200 | C24 | 1 Murata | | GCM1555C1H120GA16D | VolumeProduction | Mouser | 81-GCM1555C1H120GA6D
| GRM1555 C1H130G A01D | Multilayer Ceramic CapacitorsMLCC- SMD/SMT13pF50VDC2%0402C0G(NP0) | C26 | 1 Murata | | GRM1555C1H130GA01D | Not Recommendedfor NewDesign | Mouser | 81-GRM1555C1H130GA1D
| 100pF | Multilayer Ceramic CapacitorsMLCC- SMD/SMT100pF25VDC1%0201C0G(NP0) | C27 | 1 Murata | | GRM0335C1E101FA01J | VolumeProduction | Digi-Key | GRM0335C1E101FA01J-ND
| GRM033R 61C104KE 14D | Multilayer Ceramic CapacitorsMLCC- SMD/SMT02010.1uF16voltsX5R10% | C28, C29 | 2 Murata | | GRM033R61C104KE14D | | Mouser | 81-GRM033R61C104KE4D
| GRM155Z 71A225KE 44D | Multilayer Ceramic CapacitorsMLCC- SMD/SMT2.2 uF10VDC10%0402X7R | C30, C35, C42 | 3 Murata | | GRM155Z71A225KE44D | VolumeProduction | Mouser | 81-GRM155Z71A225KE4D
| 0.47uF | Multilayer Ceramic CapacitorsMLCC- SMD/SMT 0.47uF10VX5R10%SMD040285°CPaper T/R | C34 | 1 TaiyoYuden | | LMK105ABJ474KV8F | | Mouser | 963-LMK105ABJ474KV8F
| 1uF | Multilayer Ceramic CapacitorsMLCC- SMD/SMT1uF+/-10%10VX5R060201 | C40, C45 | 2 Samsung | | CL03A105KP3NSNC | VolumeProduction
| 10pF | Multilayer Ceramic CapacitorsMLCC- SMD/SMT10pF50VDC1%0402C0G(NP0) | C44 | 1 Murata | | GJM1555C1H100FB01D | VolumeProduction
| 5.1pF | Multilayer Ceramic CapacitorsMLCC- SMD/SMT0402MLCCNPO5.1 pF, +/- 0.1pF50VT&RGPC47, C48 | | 2 Walsin Technologies | | 0402N5R1B500CT | | Mouser | 791-0402N5R1B500CT
| BLM15PE 800SH1D | FerriteBead, 80Ohm, 25%, 0402RohsCompliant: Yes | FB1 | 1 Murata | | BLM15PE800SH1D | VolumeProduction | Digi-Key | 490-BLM15PE800SH1DCT-ND
| 600R@10 0MHz | FerriteBead600ohm500mA340mOhm0402 | FB2 | 1 Murata | | BLM15BX601SZ1D | VolumeProduction
| 9POS_CA ST | 9POSCastellatedconnector withVIA0.6 | J1, J2, J3, J4 | 4
| 10nH | Inductor RFChip Multi-Layer 10nH5%100MHz8Q-Factor Air 300mA260mOhmDCR0402Paper T/R | L1, L6, L9 | 3 Murata | | LQG15HS10NJ02D | VolumeProduction | ArrowElectronics | LQG15HS10NJ02D
| 24nH | Inductor RFChip UnshieldedWirewound 24nH2%100MHz40Q-Factor Ferrite1.3A0603Paper T/R | L2 | 1 Murata | | LQW18AN24NG80D | VolumeProduction | Mouser | 81-LQW18AN24NG80D
| LQW18AN 5N6C80D | Inductor Wirewound, 5.6 nH, 40Milliohm, ±0.2nH, 6.65GHz, 1.9A, 0603[1608Metric] | L3 | 1 Murata | | LQW18AN5N6C80D | VolumeProduction | Mouser | 81-LQW18AN5N6C80D
| 10nH | Inductor Wirewound, 10nH, 52Milliohm, ±2%, 4.75GHz, 1.6A, 0603[1608Metric] | L4, L5 | 2 Murata | | LQW18AN10NG80D | VolumeProduction | Digi-Key | 490-17899-1-ND
| LQG15HN 68NJ02D | Inductor RFChip Multi-Layer 68nH5%100MHz8Q-Factor Air 180mA1.25OhmDCR0402Paper T/R | L7 | 1 Murata | | LQG15HN68NJ02D | Not Recommendedfor NewDesign | Digi-Key | 490-1095-1-ND
| LQG15WZ 11NJ02D | Inductor RFChip Multi-Layer 11nH5%0402Paper T/R | L8 | 1 Murata | | LQG15WZ11NJ02D | VolumeProduction | Digi-Key | 490-15246-1-ND
| LQG15W H20NJ02 D | Inductor RFChip, Aec-Q200, 20Nh, 0402, 2.1GhzRohsCompliant: Yes | L10 | 1 Murata | | LQG15WH20NJ02D | VolumeProduction | Mouser | 81-LQG15WH20NJ02D
| MLZ1608 M150WT0 00 | Inductor RFShielded15µH, ±5% | L11 | 1 TDK | | MLZ1608M150WT000 | VolumeProduction | Mouser | 810-MLZ1608M150WT000
| 2.4K | Thick Film Resistors - SMD2.4 kOhms62.5 mW04021% | R1 | 1 Yageo | | RC0402FR-132K4L | | Mouser | 603-RC0402FR-132K4L
| 5.42K | Thin Film Resistors - SMD5.42kOhm,0402,1%,50ppm,63mW,50V | R2 | 1 KOASpeer | | RN73H1ETTP5421F50 | | Mouser | 660-RN73H1ETP5421F50
| 0R | ResistorsThick Film - SMD04020.063W0OhmJumper | R3, R4 | 2 Vishay | | CRCW04020000Z0ED | | Digi-Key | 541-0.0JCT-ND
| 100K | ResistorsThick Film - SMD1/20watt 100Kohms1%200ppm | R6, R7 | 2 Vishay | | CRCW0201100KFNED | VolumeProduction
| 220R | ResistorsThick Film - SMDHP02(0402) 1/10W1%220RT/R-10000 | R8 | 1 Royal Electronic Factory | | HP02WAF2200TCE | | Mouser | 303-HP02WAF2200TCE
| 10K | Resistor Thick Film Anti-SulfuratedChip 020110kOhm1%Paper T/R | R9 | 1 Yageo | | AF0201FR-0710KL | | Mouser | 603-AF0201FR-0710KL
| GRF5504 | RFAmplifier HighEfficiency, 3.5Watt PA/SaturatedPA, OP1dB>34.0 dBm; 0.4 - 0.5GHz | U1 | 1 Guerrilla RF | | GRF5504 | | Mouser | 459-GRF5504
| STM32WL 55JCI7_de tails | Multiprotocol Wireless32-bit MCUwithLPWANSub-GHzradio solution(BGA) | U2 | 1 STMicroelectronics | | STM32WL55JCI7 | | Mouser | 511-STM32WL55JCI7
| ESD_6V | ESDprotection6V1- VaristorsMLV060318V3pF | U3 | 1 STMicroelectronics | | ESDALC6V1-1U2 | VolumeProduction | Mouser | 511-ESDALC6V1-1U2
| TG2520S MN_32.00 00M-MCGNNM 0 | TCXOOscillatorsTG2520SMN32.0000M-MCGNNM0: TCXO2.8V3.3V0.5PPM-4085CNONO/E 1KTR | X1 | 1 Epson | | TG2520SMN32.0000M-MCGNNM0 | | Mouser | 732-2520SMN32MCGNNM0
| NX2012SA-32.768K-STD-MUB- | Crystals 32.768KHZ12.5PFSMD | Y1 | 1 NDK | | NX2012SA-32.768K-STD-MUB-1 | VolumeProduction | Mouser | 344-NX2012SA32768K1
