arribada/argos-smd-hw/(list of files, drawings)

Other design files:
BGA_RF-ArticGR.PrjPcb
devicesheets/CLS_1W_3.3V_Lineup.SchDoc
devicesheets/STM32RF_power_SMPS.SchDoc
devicesheets/stm32wl55jci7-details.SchDoc
module-BGA-RG.SchDoc
module-BGA_RG-4layers_v0.1d.PcbDoc
module-BGA_RG-4layers_v1.0.PcbDoc
module-BGA_RG-4layers_v2.1.PcbDoc
Project_Overview.SchDoc
