arribada/argos-smd-hw/(commit log)

2024-11-22 minor update on schematics display (after production) no changes, only overview file
2026-06-10 Add latest production files used, update project file with latest PCB opened by default
2026-10-15 Add devices sheet inside the folder
